ChristinaSaikoy/fly01-fpga-demo/reference/work12_reference/README.md

# FLY-01 MVP-DEMO-V1

能运行的第一版：录像/GIF → BY-02 红色块检测 → PixelDirectionMVP → 冻结整数
神经模型 → 原 DN/动作映射 → 屏幕。默认软件参考，默认不启动采集/计算，
默认 dry-run 禁用；没有任何电机串口或驱动字节协议实现。

## 启动

本机已有 Python、NumPy、Pillow、OpenCV，无需安装新软件：

```powershell
& 'C:\Users\54263\AppData\Local\Programs\Python\Python314\python.exe' -B 'D:\FPGA-AUTO\tasks\WORK-12\mvp_integration\app.py'
```

打开控制台输出的 `http://127.0.0.1:端口`，保留“录像/软件参考”，点“开始新会话”。
空白路径使用已审阅 BY-02 的合成 GIF，并标 REPLAY；也可填写本机 MP4/AVI/GIF。
点“停止输出”停止当前工作，不会关闭你正在使用的浏览器。关闭服务可终止自己的
app.py 进程/终端。页面不自动弹出，不连外部服务，不把合成回放称为真实相机。

源码便携包解压后，已安装相同依赖的机器可直接 `python -B app.py`。无需 Vivado
运行参考模式，也不需要访问 participant 的旧任务目录。界面只监听本机回环地址。
前后端请求有 token/origin/Host 校验；这不是向外网开放的控制服务。

## 模型和时间边界

- 不改冻结模型、311 路名册、Q=2458、dt=20ms、全局 166700 路 RNG 消耗序列。
- PixelDirectionMVP 是新工程适配，不是 WORK-08 几何合同的放宽：处理图像左/
  右/居中对应既有 L/R/双侧刺激，初始中心带 ±2px、左右镜像显式配置。
  无弧度、米制位置、虚假标定。镜像会改变实际处理坐标，不只是美化预览。
- 视觉只替换未采用观测；已经进入模型的输入、随机数及步骤写入账本，不跳步。
  输入延迟一模型步；新输入按实际采用顺序重放，不按原始所有视频帧假造一致性。
- 接收年龄上限 250ms 是非运动展示的工程值，曝光/相机缓冲延迟始终 UNKNOWN。
  模型 dt 不等于实际墙钟步率；页面分别报告视觉帧率和模型计算率。
  250ms 输入检查发生在采样时，不是端到端保证；本次接收估计到结果 P99 约
  251.8ms、最大约262.2ms，不能用模型计算均值几毫秒宣称完整交互时延几毫秒。
- 无目标/多目标/过期清空选定刺激；中性输入不是刹车，居中不是直行保证。
  DN/动作是真实模型后处理，不从像素直接合成转向。

## UART 候选与错误处理

复用 WORK-07 的编码、CRC/长度/转义和完整状态校验器，**不修改其文件**。
新增主机流式重同步层；有效结果必须匹配操作、会话、帧、视图和代次。
保留 500ms、一次同事务重试：FRAME/ACK 等最多两次相同请求，不擅自缩短超时。
一模型步 FRAME＋ACK 的名义 I/O 等待最多 2s；任何不确定结果不进入后处理。
复位不自动重试；ACK 不确定时也不发布该步、不给出下一个神经步。

FAULT 后不自动恢复。操作者可明确选择“恢复本进程先前拥有的会话”，确认
旧会话复位后释放，建立新会话，模型、RNG、预处理器和仿真身体全部从 0 开始；
跨进程重启遇未知旧 owner 不擅自夺取。来源、代次和重新归零都有日志。

新真实板测需 Controller 提供当前候选绑定的 **新**授权和准确装载回执：旧许可
不可直接使用。Windows 原 VID/PID/PnP/拓扑/独占串口检查仍生效。另要求
`mvp_scope.name=MVP-DEMO-V1_NON_MOTION`、
`restart_policy=EXPLICIT_SAME_PROCESS_WITHIN_WINDOW` 和本次监督器开始时的
`suite_started_monotonic_ns`；授权使用记录独占绑定到进程，不能跨进程重放。
自该时刻 1795s 后禁止发起/等待新事务，给 1800s 上限预留收尾时间。
这不是已完成整套板测/计时的证明；烧录前的总监督器接续和实测仍待授权阶段完成。

历史生产 O8 bit 为 93399a70892ece88300af96cd2dd27566b683f9eeecc41f394465182b5786eb4；
未假定当前仍在板上。WORK-11 未批准观察版不是本原型依赖。新 FPGA 后端尚未
做物理连接/验收；软件注入不能证明真实 UART 已恢复可靠或旧严格报文/50Hz 通过。

## 相机与执行器

本轮仅只读发现 Christina 的 HD Webcam/IR Camera，没有打开它们。真实相机
需要新 JSON 授权：status=APPROVED_CAMERA_PREVIEW、准确 execution_host /
camera_index、scope=LOCAL_PREVIEW_NO_RAW_RECORDING。请由总控绑定新同意范围，
不要自己把旧材料的 verified/APPROVED 标志改真。首轮只拍桌面红卡、无人脸证件；
程序只保存观测/计算日志，不录制原始相机视频。

动作接口只有 dry-run：必须显式使能，过期/丢目标/结束/故障锁存禁用，再次手动
使能才恢复。示例 v/yaw 限幅只是日志用工程数值，不是已批准电机规格。
它没有独立硬件看门狗，不能因 PC 软件 poll 正常就允许实体运动。
BY-03 的驱动型号/协议/编码器和独立超时停车尚未收到，不猜测接线、轮速或字节。

## 复核

```powershell
python -B checks.py --output D:/.../一个不存在的输出目录
python -B replay.py D:/.../实际运行目录 --output D:/.../新的重放结果.json
```

检查是软件注入和参考重放；最终证据见 DELIVERY.json。20 项新增测试、原主机
14 项中的 12 通过/2 平台跳过分别统计。UI 的开始/停止/无设备授权拦截、移动
布局及普通视频文件解码另有实际记录；真实相机、UART、运动不是已通过项。

开发过程保留：ui_01 因未装 Playwright 自带浏览器失败，改用已安装 Edge 的
无窗口隔离实例，没有安装软件；ui_02 预览溢出，修正后 ui_03/05 实测。
早期 demo_3min 开发运行和 demo_final_r1 发生候选 hash 变化，不作为最终演示
验收；最终只引用候选全过程一致的 demo_final_r2。旧日志未抹除。
