ChristinaSaikoy/fly01-fpga-demo/src/edge/o7_transport/README.md

# O7 accepted transport snapshot

O7 accepted functional+full-suite scope: 5400/5400 exact state checks, 600-frame audit, 200-frame mode comparison, three 1000-frame online rounds and scoped fault evidence; package 205.7985633 s.

Stable 50 Hz remains FAIL; P99: 30.819 / 32.476 / 30.220 ms. The physical configuration bit SHA256 was 1ccfb37cbfd603bc8409196d1e3b61af20b4df7225b1ef5c781e5c7cce4af3e7. Bitstream not redistributed here.

This is a selected verbatim source snapshot, not a full executable build bundle. Vendor Vivado IP/install, generated databases, raw traces, secret authorization receipts and full frozen vectors are excluded. Historical test drivers may depend on external path configurations; review/port their paths before use and never rerun hardware with consumed authorization.

[Accepted O7 decision](../../../docs/controller/2026-10-14/FLY01_WORK04_O7_CONTROLLER_ACCEPTANCE_2026-10-14.md).
