ChristinaSaikoy/fly01-fpga-demo/report/ai_collaboration.md

# 工程AI协作案例：O7无损输入传输

用途：可粘贴至报告的工程协作栏；下列引文为逐字节选，其余文字是本轮整理总结。仅覆盖指定历史O7制品，不代表新自主整机通过。公开选用版不含个人路径、聊天ID、设备序列号或队员身份。

## 可直接粘贴的工程段落（总结，不是对话原文）

在输入通信成为瓶颈后，用户转交的工程约束要求保持科学模型、事件顺序和完整诊断不变。AI据此提出固定编码候选，并落实连续10-bit无损传输；FPGA恢复原刺激及噪声事件顺序。指定历史O7完成5400步完整状态精确核对，整套测试约205.799秒。159个高负载历史配对帧中，平均请求字数184.99降至64.49；观察到写入均值21.743降至11.350毫秒，但尾部未改善，严格50Hz仍失败。总控复核将功能、无损压缩收益、额外逻辑成本与实时性分项接收，没有把均值改善写成全面达标。由于两个版本的bit、输出字数和历史主机负载不同，时延变化不能全部归因于编码。此案例形成的复用规则是：先固定输入与参考，再绑定制品比较完整输出，同时报告均值、尾部、资源代价和失败边界。

## 少量真实原文

用户消息中的以下文字是**用户转交的工程指令**，不宣称由用户独立原创技术推导。来源ID：O7-1。

> - 新发现：**高输入负载时，写入明显变慢**。下一步优先验证输入无损压缩、FPGA 按原顺序还原；不保证压缩就一定解决所有长尾。

助手实际方案节选，来源ID：O7-2；从原消息的“我会先比较”开始连续摘取，未改写。

> 我会先比较两种固定编码，优先选一种简单方案，减少切换模式的验证负担；无论选哪种，都必须按原刺激升序、再噪声升序还原事件，保留全部输出诊断。

助手阶段结果原文，来源ID：O7-4。

> 完整真板套件已完成，总计约 3 分 26 秒，功能和新编码故障检查通过。平均整帧降到了约 10–11 ms，但三轮 P99 仍约 30–32 ms，50 Hz 仍未通过。我正在独立重算原始证据，并把高负载写入改善与剩余长尾分开报告。

## 结果、总控裁决与复用边界

- 助手答复本身不是实验凭证。证据选定字段见[历史结果](public/historical_evidence_fields.json)；正式5400步子阶段约103.244秒，与205.799秒整套计时不同。
- 原执行记录保留SUBMITTED_FOR_REVIEW及controller_acceptance=PENDING；后续总控分项接收不倒改旧文件。总控为另一AI审核线程，其裁决由用户转交；不据此宣称用户本人逐项重算。历史三轮P99约30.82/32.48/30.22毫秒，50Hz失败保留；资源不是整体下降，而是以额外逻辑换输入字数与观察到的平均改善。
- 复用模板见[传输优化核验规则](public/transport_optimization_rule.md)。这是总结所得模板，不是新增技能测试或证明适用于任意协议；本轮未将它安装为全局技能。
- 一例已经完整，无需为凑数量再补HY R2“已修好”案例。新自主顶层、实景转向、独立供电及停止恢复仍按其各自实测与总控裁决，不从O7继承。

材料线程可只选以上三段引文中的两段配原始结果卡；标“真实工程对话节选”，不用假聊天UI。逐字来源与角色见[公开节选](public/engineering_excerpts.json)，私人定位索引仅在internal供本地核验，不能随报告、RAR或视频导出。
