ChristinaSaikoy/fly01-fpga-demo/reference/work12_reference/HANDOFF.md

# WORK-12 一页交接｜2026-10-19

状态：`PARTIAL_WITH_BLOCKERS / MVP-DEMO-V1 软件增量提交总控审核`。
**已可用：回放 → 检测 → 原神经计算 → 屏幕；不是相机/真板/整车验收。**

## 给 participant

运行 `python -B app.py`，打开输出的本地网址，默认录像＋软件参考，点开始。
不要改 approved/verified 标志，也不要把 dry-run 当成电机启动。
真实设备先集中确认：①允许 HD Webcam 仅拍桌面红卡、本地预览、不录原视频；
②准备电源、JTAG 和 **USB_UART**，届时新授权绑定生产 O8 bit 93399a70…及本
候选 SHA；③有小车/驱动/电池时一次提供准确型号/照片，未知前不猜接线或下单。
只读设备检查发现 HD Webcam；未见 CH340，因此不能称当前已可上板。

## 给成员B HY-04

直接使用交接目录 `HY04_O8_PRODUCTION_BUILD_2026-10-19.zip`，不是让你从 main
猜缺项。含生产 O8 的 15 份 RTL、35 份 ROM、XDC、实际已升级 XCI 和一条本地
构建入口，来源/56 项 hash 已给；不含账号、授权回执、旧 bit 或原数据库。
先 `python -B build.py`，再按 README 填本机 Vivado 2025.2 路径构建一次。
Work 已做输入闭包自检，**没有替你运行新完整构建**；报告资源、时序和全部告警。

## 给成员A BY-03

本机尚未收到新交付，当前集成沿用已审 BY-02。请一次补增量包，不重写检测器：
真实视觉入口；已有/在途/待买清单；准确驱动/协议/供电/编码器；主机断联后
驱动自身超时停车依据；一张布局与装配顺序图。先给准确具体缺项，不虚构库存。
Work 方向输出采用 PixelDirectionMVP，角度/距离未知仍未知，不另造神经模型。
设备未定时动作只用 v/yaw dry-run 日志，不猜驱动字节或轮距。

## 给总控/后续 Work

当前版本、真实数据和测试数值集中在 DELIVERY.json；启动说明 README.md。
最终演示证据 `evidence/demo_final_r2/`，独立按**实际采用账本**重放至全状态、
DN、预处理、映射与身体；短录屏 screen.gif 是 REPLAY＋SOFTWARE_REFERENCE。
20 项新增用例、原 12 通过/2 跳过、UI/视频文件检查分开，不升级为物理测试。
新主机候选原编码/科学加载器未改；坏包丢弃，同事务有限重试，结果不确定停止，
人工重建会话后从 0 开始。旧严格报文/50Hz FAIL 保留。

下一次合并申请：准确旧生产 bit 的重新装载＋必要身份检查＋一次既有 5400 步
完整状态里程碑回归＋3 分钟新 UART 非运动交互；含烧录到报告仍 ≤30 分钟。
沿用 WORK-07 formal 函数/已冻结输入，挂接本候选和新的总监督器/许可后才运行，
**本轮没有声称该硬件总入口已实测**。先相机/屏幕，再架空电机/独立停机，最后
低速落地；本包不放行实体运动。未推 GitHub、发队友、采购或外发。
