ChristinaSaikoy/fly01-fpga-demo/reference/vision/FLY01_BY02_VISION/team-work/bangyi/by02/HANDOFF.md

# FLY-01｜视觉代码与硬件预设交接

日期：2026-10-15。任务：`BY-02-VISION-PREINTEGRATION-V1`。状态：`SUBMITTED_FOR_REVIEW`。这是本轮视觉代码与硬件预设交付，供后续K230和项目主机接续。

## 基线与范围

- GitHub main 已实时核对为 `edebc9768346023ba02fa9cdf285472724ebf87d`。
- 使用现有电脑组件：Python 3.13.9 / NumPy 2.3.5 / Pillow 12.0.0。
- 复用 BY-01-R1 红色检测的阈值、4邻域连通块、质心和半开边框规则；8张原样例PNG字节不变，来源与SHA见 `provenance/SOURCES.json`。
- 本次编辑位于新的任务交付目录，未修改旧成果、冻结神经模型、DN映射或远端仓库。

## 已实现

1. 图片／图片目录、GIF逐帧输入，输出带框画面与JSONL。
2. 唯一目标、无目标、多目标状态；镜像与旋转的坐标处理；没有合格唯一目标时清空选择。
3. 会话、视觉帧号、源类型、可空采集时间、媒体时间与本进程单调时钟分层记录。
4. 处理超期、重复／倒序、错误、EOF清选中目标；供调用者使用的poll接口。
5. 项目反馈提案：复用schema_version0.1、objects、几何、k/k+1字段，默认BLOCKED并说明原因；不编造方位角或米制位置。
6. K230 JSONL校验、结果回放、坐标转换、消息组包函数与 `process_k230()` 接入点。
7. 可选延迟加载的OpenCV视频／PC相机入口；当前环境无OpenCV，已验证缺依赖时的明确失败出口。
8. 中文代码注释和集中设置；`HARDWARE_PRESET.md`、`ASSEMBLY_TUNING.md`说明装车后需要测量与修改的项目。
9. 无外部依赖的离线预览、入口使用文档、依赖清单和文件校验器。

## 检查结果

- 28项自身软件检查通过。覆盖8张原样例真值、旋转/镜像、角度符号、未知几何、不沿用旧目标、过期/错误/EOF、K230消息边界与项目接洽约束。
- 图片、GIF、K230 JSONL 三个实际入口各处理8帧：5 VALID、2 NO_TARGET、1 AMBIGUOUS；另写INPUT_ENDED。
- 现有输出目录拒绝覆盖：退出2，旧结果哈希不变。
- 缺少可选OpenCV：退出1，summary明确FAILED，结束记录包含停止边界；不是视频或相机能力通过。
- 对从固定GitHub提交读取的原样冻结编码器做了3个合成字段兼容检查：左165路、右146路、中311路，q仅0/2458，反馈8→神经步9。仅证明编码器输入子集、左右符号和步号字段可接洽；未执行神经运行时或完整Body合同检查。
- 独立代码检查发现两项API失效处理缺口（坏帧可能留下旧选择、首帧前结束缺停止标记），均已修复并对两处定向复核通过。

机器结果见 `evidence/UNIT_TESTS.json`、`ENTRYPOINT_CHECKS.json`、`ENCODER_COMPATIBILITY.json`。视觉summary中的PASS仅是本次输入处理成功，不是识别准确率、真板、K230或闭环验收。

## 实物到位后接续

1. 记录K230 PCB、固件、相机型号与USB枚举；确认采集和应用数据通道。
2. 调整 `settings.py` 中标注的方向、镜像、相机请求值、红色阈值和最小面积。
3. 在真实分辨率与安装状态下做方向标定；未知内参／外参保持null/false。
4. 按实际固件补板端采集、检测和真实传输；本包不是可直接烧录的K230固件。
5. Work确定方向观测如何进入正式反馈合同，处理模型步号、时钟映射、实时通道与执行器停止。

当前没有真实相机/K230/串口/FPGA/电机访问，没有形成真机精度、曝光时延或实时性能结论。当前不依靠修改配置字符串来宣称这些能力已经实现。

## 使用与打包

解压到任意目录，进入 `team-work/bangyi/by02/`，运行：

```powershell
& 'D:\Anaconda3\python.exe' .\verify_delivery.py
& 'D:\Anaconda3\python.exe' .\run_vision.py
```

也可双击 `run_images.cmd`，它使用当前电脑的Anaconda路径。结果位于新建的runs目录。先看 `README.md` 和 `VISION_USAGE.md`；装车后搜索代码中的 `装车后调整`。

交付包仅含本任务目录。`PACKAGE_MANIFEST.json`排除自身、运行缓存与用户新生成的runs；外部ZIP SHA256与清单配套。未公开、未推送、未合并、未烧录。
