ChristinaSaikoy/fly01-fpga-demo/docs/images/camera.jpg

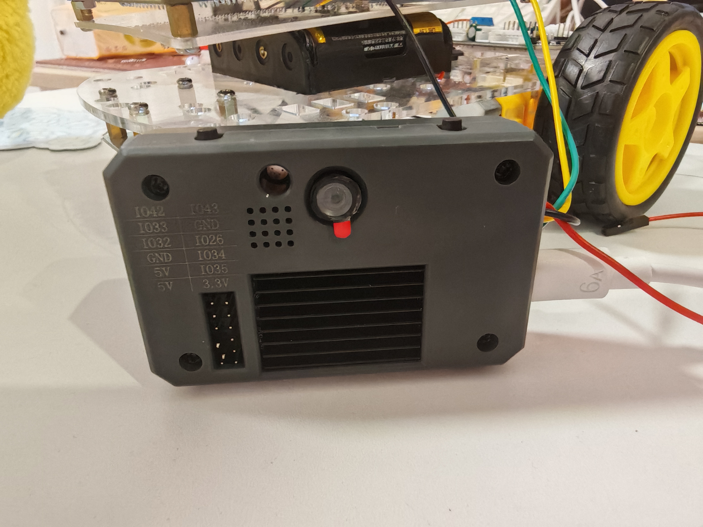
docs/images/camera.jpg
