ChristinaSaikoy/fly01-fpga-demo/docs/images/driver.jpg

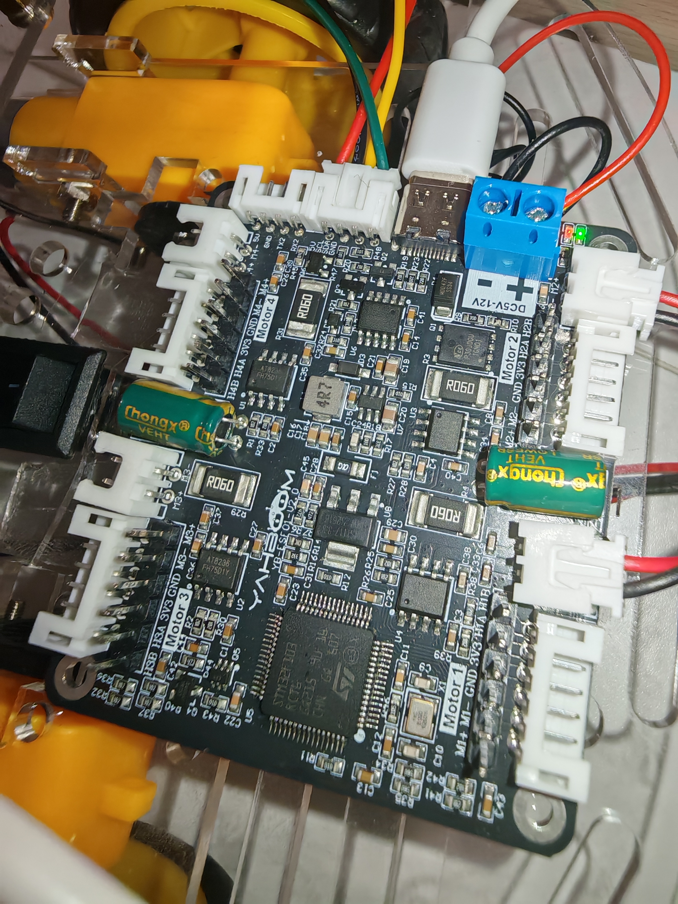
docs/images/driver.jpg
