ChristinaSaikoy/fly01-fpga-demo/docs/images/fpga.jpg

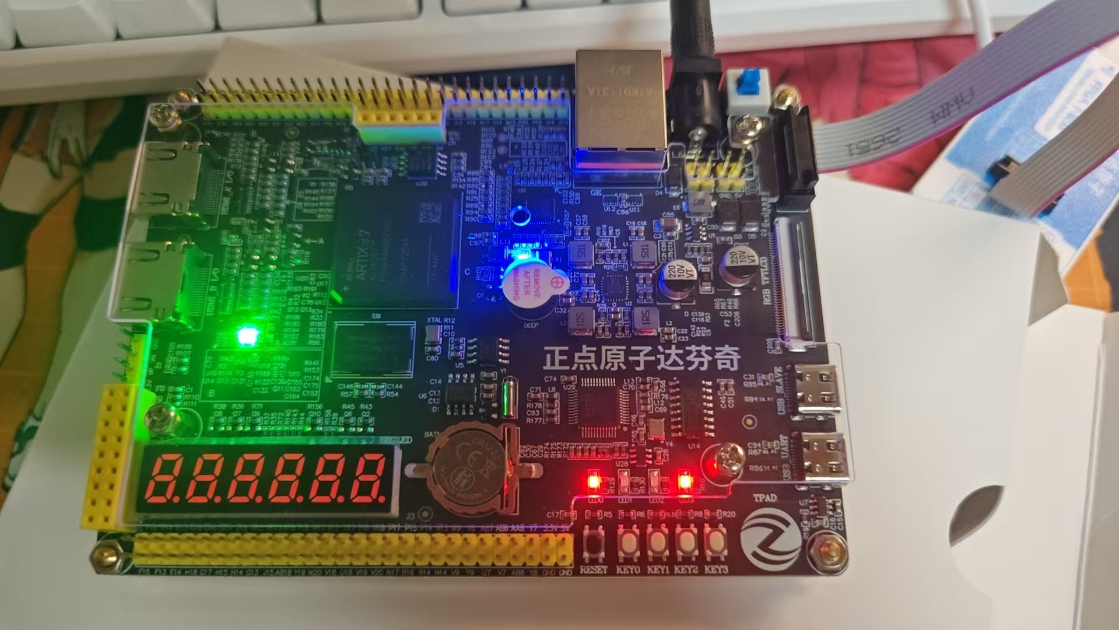
docs/images/fpga.jpg
