ChristinaSaikoy/fly01-fpga-demo/evidence/work29/CHASSIS_PANEL.png

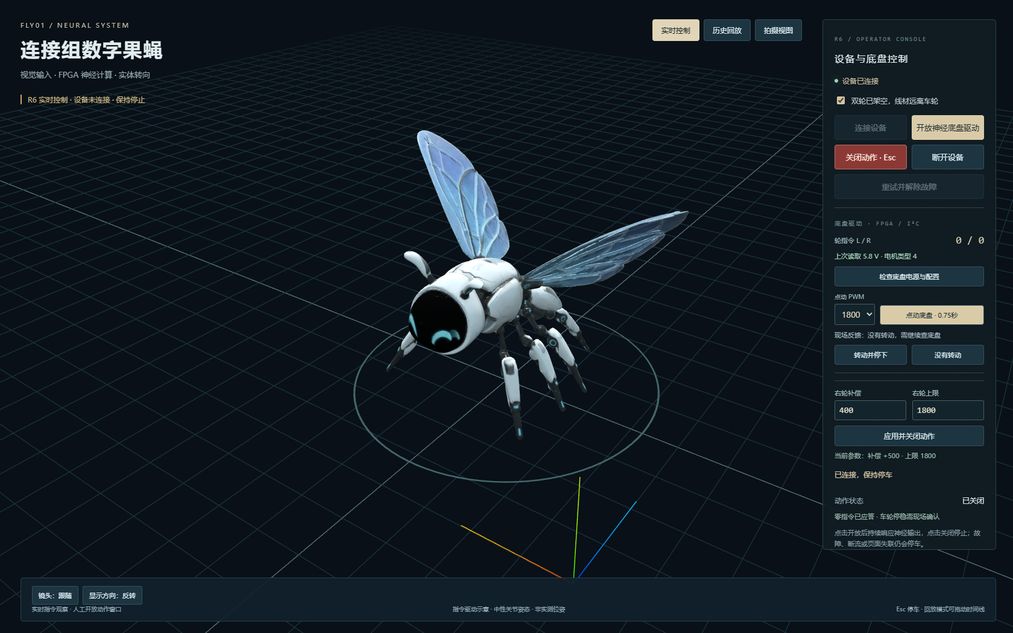
evidence/work29/CHASSIS_PANEL.png
