ChristinaSaikoy/fly01-fpga-demo/reference/desktop/assets/images/01_left.png

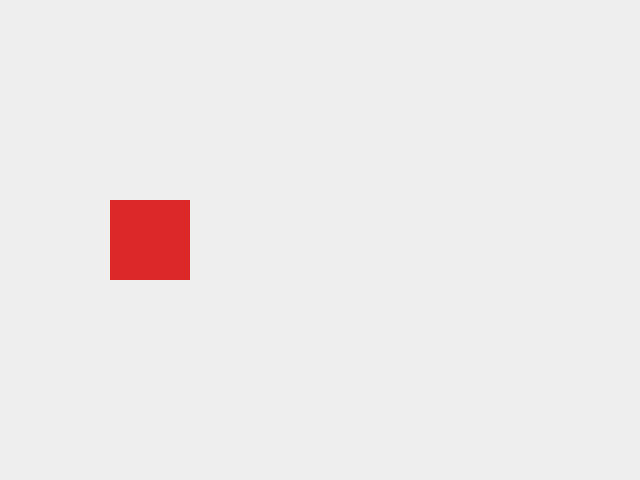
reference/desktop/assets/images/01_left.png
