ChristinaSaikoy/fly01-fpga-demo/reference/desktop/assets/images/02_right.png

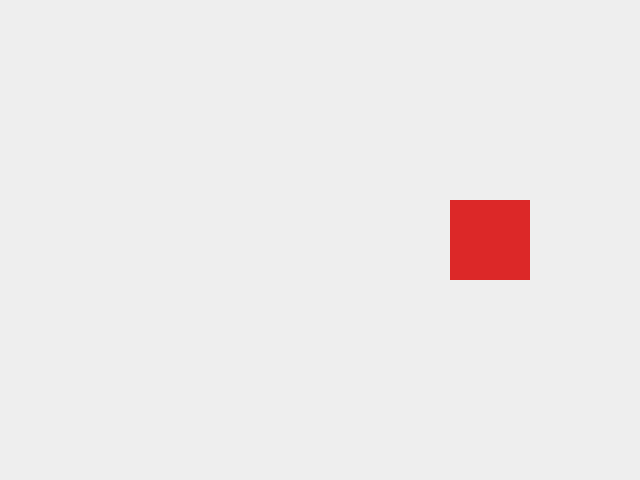
reference/desktop/assets/images/02_right.png
