ChristinaSaikoy/fly01-fpga-demo/reference/desktop/assets/images/03_center.png

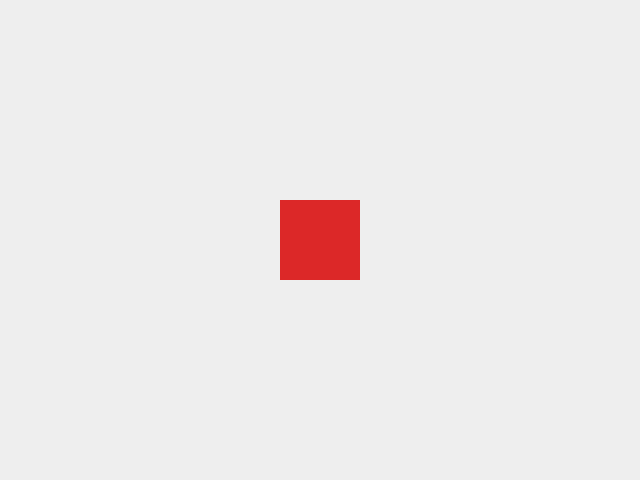
reference/desktop/assets/images/03_center.png
