ChristinaSaikoy/fly01-fpga-demo/reference/vision/FLY01_BY02_VISION/team-work/bangyi/by02/examples/image_run/annotated/frame_000001.png

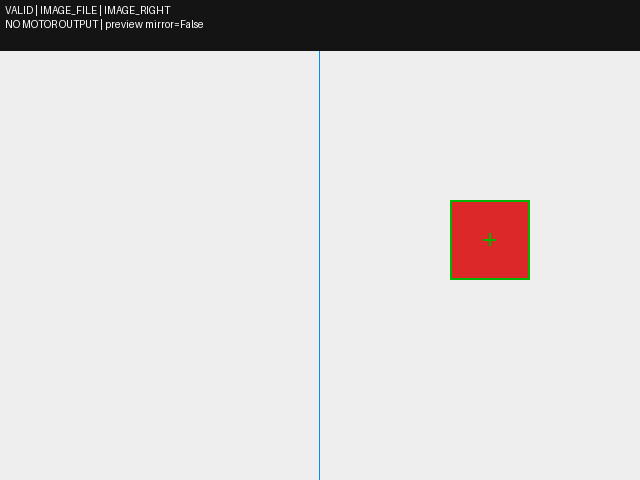
reference/vision/FLY01_BY02_VISION/team-work/bangyi/by02/examples/image_run/annotated/frame_000001.png
