ChristinaSaikoy/fly01-fpga-demo/evidence/work29/RESULT.md

# 上位机底盘驱动接续

2026-11-04。运行页面：http://127.0.0.1:8881/。

## 真实结果

用户明确电机电池已开启，但此前神经开放期间未观察到运动。读回驱动板电压 5.8 V、固件 1.7.3、电机类型 4、死区 1600。R13 日志包含正反两个方向的非零 I²C 应答，不能凭此认定车轮实际转动。

新增页面“点动底盘 · 0.75秒”后，用户亲自点击固定 1800 档，通过 FPGA UART 的 3/B 触发现有 FPGA 限时诊断，再由 FPGA I²C 发送 -1800/+1800。页面记录应答，用户明确反馈“双轮转动并停下”。现场结果已通过 chassis_feedback 记录进同一日志。点动完成后零指令应答正常、动作关闭、I²C 无故障。

这证明该次真实上位机→FPGA→I²C→驱动板→双轮及停车链路可工作。尚未证明 K230 神经自动动作在同一现场稳定有效，也未确认此前不动的唯一根因。弱神经执行指令的幅度、持续性及负载仍是后续核查方向，不宣称已经解决所有自动控制问题。

## 页面功能

- “开放神经底盘驱动”：保留 K230→FPGA 神经控制；三维姿态仍为指令示意，无编码器反馈。
- “检查底盘电源与配置”：先停，再用驱动板 USB 只读查询；结果注明上次读取，不自动点动、不改驱动板固件或 Flash。
- “点动底盘 · 0.75秒”：可选 1200/1600/1800；用户点击后由 FPGA 固定限时；与神经开放互斥。
- 轮指令、使能状态、现场“转动并停下/没有转动”分开显示；ACK 不冒充实体反馈。
- 显式关闭、Esc、断流/页面失联保护和 USB 备用零命令保留。
- 修正持续开放模式的旧宿主门槛：非零 Q20 输出可以请求开放，不再先截成整数 PWM 而错过 R13 微弱输出。

## 验证、部署和回退

78 项宿主测试通过，针对性浏览器检查及 HTTP 来源/令牌检查通过。浏览器测试使用隔离模拟接口，没有访问硬件；真实只读检查和用户点动反馈另存于 FINAL_STATUS.json、RESULT.json 以及运行日志。

差异见 CHANGES.diff，原文件备份在 before/。没有新增 RTL、没有重新烧录，FPGA 继续 R13 临时配置，Flash 仍 R11。

当前后台 PID 39288，由受管理命令会话 58009 运行。常规后台启动被自动审批拦截后，已在用户批准重启的范围内使用可跟踪前台命令会话启动。关闭该命令会话会结束服务。不得用全局 node.exe 清理命令关闭其他服务。

回退需先关闭动作并断开设备，再恢复 before/ 中的对应文件并重启此服务；不覆盖运行日志。
