ChristinaSaikoy/fly01-fpga-demo/vision/k230_r5/frozen_noise.py

"""Exact frozen PCG64 stream, selected 471/166700; unbounded by file length."""
MASK128=(1<<128)-1
MASK64=(1<<64)-1
MULT=47026247687942121848144207491837523525
INITIAL=169315560903244463742157973610348829933
INC=284108541179697586677118184078770124551
THRESHOLD=216172782113784
NODES=[0, 6, 12, 15, 61, 92, 103, 131, 132, 133, 156, 178, 204, 207, 213, 230, 236, 238, 242, 261, 275, 333, 345, 384, 413, 444, 545, 559, 680, 696, 722, 803, 853, 861, 915, 917, 945, 1020, 1052, 1070, 1101, 1242, 1282, 1375, 1398, 1491, 1565, 1704, 1770, 1799, 1800, 1899, 1908, 1972, 2071, 2091, 2092, 2097, 2109, 2127, 2195, 2228, 2262, 2345, 2607, 2642, 2684, 2915, 2923, 2932, 3360, 3475, 3509, 3538, 3568, 3755, 3806, 3817, 3821, 3939, 4134, 4517, 4635, 4681, 4857, 4990, 5148, 5209, 5274, 5329, 5341, 5352, 5509, 5623, 5631, 5908, 5921, 5936, 5943, 5980, 6080, 6108, 6241, 6324, 6336, 6349, 6457, 6462, 6468, 6572, 6631, 6647, 6650, 6663, 6711, 6735, 6746, 6837, 6896, 6899, 6902, 6907, 6955, 6997, 7010, 7107, 7108, 7186, 7205, 7230, 7245, 7257, 7296, 7299, 7421, 7476, 7612, 7663, 7695, 7734, 7863, 7907, 8115, 8121, 8143, 8150, 8240, 8341, 8371, 8410, 8427, 8438, 8470, 8575, 8605, 8685, 8690, 8691, 8726, 8745, 8767, 8903, 8908, 8942, 8953, 9015, 9028, 9050, 9053, 9107, 9135, 9186, 9235, 9253, 9307, 9331, 9344, 9384, 9388, 9444, 9475, 9479, 9507, 9564, 9570, 9598, 9610, 9614, 9694, 9711, 9761, 9805, 9813, 9859, 9911, 9951, 9958, 10021, 10115, 10126, 10184, 10242, 10254, 10264, 10268, 10284, 10290, 10307, 10336, 10472, 10483, 10552, 10608, 10625, 10670, 10704, 10708, 10757, 10789, 10912, 11061, 11079, 11084, 11115, 11122, 11166, 11185, 11387, 11411, 11495, 11583, 11655, 11722, 11759, 11768, 11876, 11963, 11986, 12004, 12097, 12137, 12182, 12224, 12270, 12306, 12375, 12493, 12572, 12611, 12620, 12783, 12846, 12919, 12957, 12985, 13045, 13146, 13178, 13210, 13387, 13422, 13591, 13688, 13753, 13792, 13804, 13821, 13846, 13959, 14014, 14027, 14038, 14082, 14085, 14093, 14138, 14335, 14556, 14587, 14810, 14832, 14930, 15112, 15274, 15368, 15517, 15663, 15705, 15767, 15855, 15901, 15905, 15988, 16019, 16063, 16092, 16248, 16255, 16283, 16413, 16903, 17019, 17081, 17114, 17145, 17298, 17326, 17385, 17414, 17477, 17499, 17543, 17586, 17634, 17664, 17764, 17812, 17867, 17905, 17917, 17989, 18018, 18069, 18106, 18196, 18206, 18444, 18472, 18729, 18798, 18808, 18810, 18844, 18994, 19116, 19119, 19155, 19161, 19266, 19384, 19735, 19758, 19968, 19977, 20221, 20300, 20419, 20766, 20808, 20915, 21001, 21010, 21040, 21263, 21503, 21580, 21630, 21864, 21893, 22110, 22133, 22182, 22276, 22649, 22677, 22964, 22980, 23023, 23162, 23206, 24566, 24704, 24729, 25003, 25128, 25546, 26505, 27556, 27585, 27813, 35821, 37769, 40408, 49060, 53252, 54246, 57570, 57688, 58457, 61225, 64754, 69049, 72043, 75609, 75901, 80999, 84063, 84153, 84429, 95909, 98801, 123847, 125827, 125936, 126072, 126264, 126836, 126837, 127132, 127249, 127264, 127361, 127525, 127807, 128063, 128100, 128669, 128773, 128774, 128976, 129156, 129185, 129319, 129563, 129627, 129746, 129747, 129906, 130141, 130158, 130298, 130350, 130450, 130617, 130739, 130920, 131061, 131182, 131863, 132042, 132079, 132276, 132556, 132975, 133046, 133176, 133603, 133655, 133709, 133710, 133712, 133770, 134283, 134306, 134783, 135090, 135203, 135204, 135250, 135252, 135368, 135680, 135787, 136179, 136248, 136845, 137274, 142416, 142630, 143169, 144261]

def coefficients(delta):
    mul=1;add=0;m=MULT;a=INC
    while delta:
        if delta&1:mul=(mul*m)&MASK128;add=(add*m+a)&MASK128
        a=((m+1)*a)&MASK128;m=(m*m)&MASK128;delta>>=1
    return mul,add

class Noise:
    def __init__(self):
        self.jumps=[];previous=-1
        for local,node in sorted(enumerate(NODES),key=lambda v:v[1]):
            m,a=coefficients(node-previous);self.jumps.append((local,m,a));previous=node
        self.cached_step=None;self.cached=None
    def row(self,step):
        if not 0<=step<=0xffffffff:raise ValueError('Noise step outside protocol')
        if step==self.cached_step:return self.cached
        m,a=coefficients(step*166700);state=(INITIAL*m+a)&MASK128
        result=bytearray(59)
        for local,m,a in self.jumps:
            state=(state*m+a)&MASK128
            x=((state>>64)^state)&MASK64;rot=state>>122
            raw=((x>>rot)|(x<<((-rot)&63)))&MASK64
            if (raw>>11)<THRESHOLD:result[local>>3]|=1<<(local&7)
        self.cached_step=step;self.cached=bytes(result)
        return self.cached
