ChristinaSaikoy/fly01-fpga-demo/src/edge/fpga/sim/tb_wrapper_xsim_tops.sv

`timescale 1ns/1ps
module tb_wrapper_xsim_seed0; tb_wrapper_full #(.DEFAULT_SEED(0)) u(); endmodule
module tb_wrapper_xsim_seed1; tb_wrapper_full #(.DEFAULT_SEED(1)) u(); endmodule
module tb_wrapper_xsim_seed2; tb_wrapper_full #(.DEFAULT_SEED(2)) u(); endmodule
module tb_wrapper_xsim_seed3; tb_wrapper_full #(.DEFAULT_SEED(3)) u(); endmodule
module tb_wrapper_xsim_seed4; tb_wrapper_full #(.DEFAULT_SEED(4)) u(); endmodule
module tb_wrapper_xsim_seed5; tb_wrapper_full #(.DEFAULT_SEED(5)) u(); endmodule
