ChristinaSaikoy/fly01-fpga-demo/(commit log)

2026-11-04 Publish R13 FPGA neural demonstrator and submission snapshot
    [FINAL_DN_MOTOR_MAPPING_V1_0.json, SENSORY_INPUT_POPULATION_311.csv, formal_expected.csv, formal_plan.csv, sequence20_expected.csv, sequence20_plan.csv, single_expected.csv, single_plan.csv]
2026-11-04 Preserve exact scientific snapshot bytes during Git transfer
    [FINAL_DN_MOTOR_MAPPING_V1_0.json, SENSORY_INPUT_POPULATION_311.csv, formal_expected.csv, formal_plan.csv, sequence20_expected.csv, sequence20_plan.csv, single_expected.csv, single_plan.csv]
